alpserkanmerkit/ortam-aurora/docs/threat-model.png

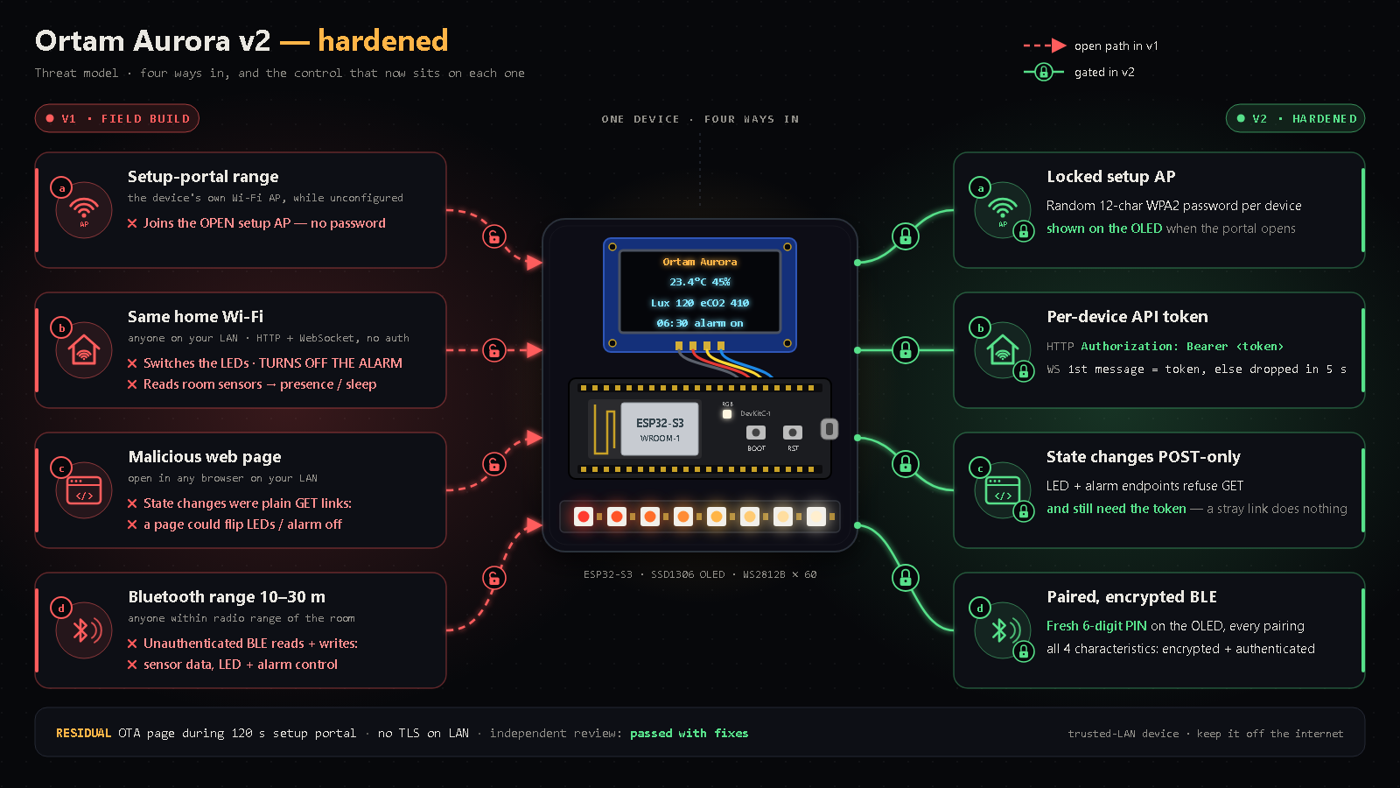
docs/threat-model.png
